joberger95/projet_BTS/Projet_BTS_2018/Programme/Problemes_Elec.JPG

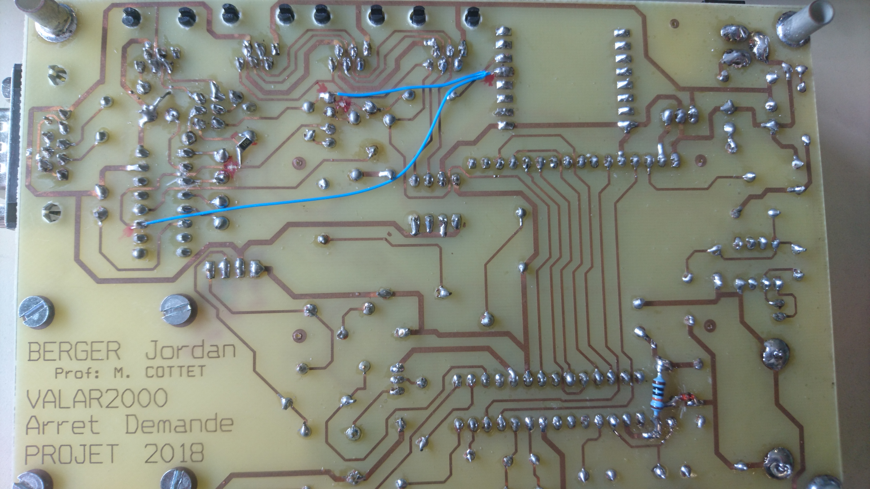
Projet_BTS_2018/Programme/Problemes_Elec.JPG
