joberger95/projet_BTS/Projet_BTS_2018/Dossier Module 4/Valideur V2000_Arrêt Demandé/Documentation/_Schéma Structurel/DSC_0121.JPG

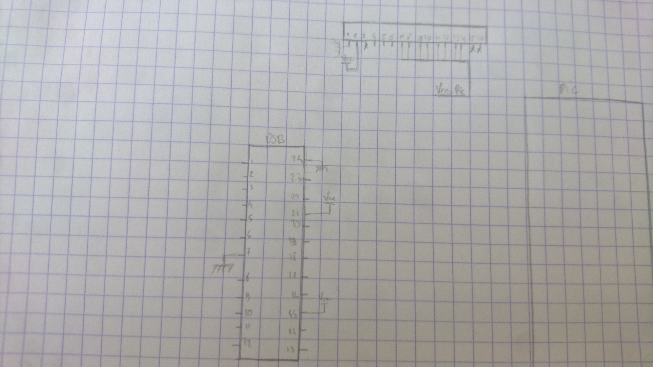
Projet_BTS_2018/Dossier Module 4/Valideur V2000_Arrêt Demandé/Documentation/_Schéma Structurel/DSC_0121.JPG
