joberger95/projet_BTS/Projet_BTS_2018/Programme/GSM_CPIN.txt

ANALOG
Ch 1 Scale 2 V/, Pos -250 mV, Coup DC, BW Off, Inv Off, Imp 1M Ohm
     Probe 10 : 1, Skew 0 s
Ch 2 Scale 2 V/, Pos 4.025 V, Coup DC, BW Off, Inv Off, Imp 1M Ohm
     Probe 10 : 1, Skew 0 s

TRIGGER
Sweep Mode Auto, Coup DC, Noise Rej Off, HF Rej Off, Holdoff 40.0 ns
Mode EDGE, Source Ch 2, Slope NEG, Level 1.25 V

HORIZONTAL
Mode WIND, Ref CENT, Main Scale 2 s/, Main Delay 9.64 s

ACQUISITION
Mode NORM, Realtime On, Vectors On, Persistence Off
