joberger95/projet_BTS/Projet_BTS_2018/Programme/Fiche_Recette.docx

FICHE RECETTE

RS232 chronogramme

I2C chronogrammes

Température

Heure

GSM chronogramme

Tension de Pile……………………………………………………………………………………………………………………OK

Alimentation générale………………………………………………………………………………………………………..OK

Bouton-poussoir…………………………………………………………………………………………………………………OK

LED………………………………………………………………………………………………………………………………….... OK
