joberger95/projet_BTS/Projet/Dossier Commun/Rapport_Projet.docx

BERGER Jordan BOUZJALLIKHT Ilyas GERMANT Rémy JOUY Florent

Arrêt Demandé

VALIDEUR V2000

Professeur : M. COTTET Jean-Jacques

# 2 PRESENTATION DU PROJET

L’association Arrêt Demandé s’occupe de la restauration, la rénovation et la remise en route de véhicules ayant roulés sur l’agglomération orléanaise. Par la préservation de ces véhicules passe la remise en œuvre des valideurs de tickets de ceux-ci. La difficulté étant la présence des pièces sur le marché ainsi que le manque de compétences dans ce domaine par les différents membres de l’association, leur ont permis d’être convaincu de faire appel à notre équipe.

Notre rôle sera de « mettre à jour » ces valideurs par l’apport de nouvelles solutions technologiques ainsi que par des solutions de maintenances efficaces et simplistes.

# 3 CAHIER DES CHARGES

Le projet propose la mise en œuvre des valideurs V2000 en réalisant de nouvelles cartes PIC et des logiciels programmés en C, qui assureront le déplacement, ainsi que les différentes parties lectures et impressions du ticket. Il se doit aussi être inséré des modules électroniques de communication pour permettre la supervision et la maintenance aisée du valideur. Il devra donc être présent un port USB et RS232 pour la récupération directe des données ainsi qu’une option GSM qui assurera l’envoi de SMS de dysfonctionnement(s) mais aussi capable de répondre à une demande d’informations.

Au vu de la complexité du système présent, les nouvelles cartes devront être reliées à la carte mère existante afin d’en conserver certaines parties, comme l’alimentation à découpage ou le bloc moteur.

La réussite de ce projet est essentielle car seuls des bus ont été remis en état pour des démonstrations, ne manquant plus que les valideurs. Le développement pourrait être poursuivi par l’utilisation de technologies CMS ou l’étude des valideurs V3000. L’idée de technologies innovantes comme l’utilisation de smartphones pour leurs modules NFC, RFID, etc… permettraient de motiver les jeunes de l’association et d’attirer un public plus large.

# 4 Schémas fonctionels

## 4.1 Schéma général

## 4.2 Schéma FP1_Motorisation et Puissance

## 4.3 Schéma FP2_Impression du Ticket

## 4.4 Schéma FP3_Lecture/Ecriture Magnétique

## 4.5 Schéma FP4_Centralisation des Données

# 5 COÛTS

Après plusieurs comparaisons et recherches sur les différents composants des cartes, le tableau suivant est ressorti :

*Tableau des coûts

Lycée Maurice GENVOIX 8 Année 2017-2018
