joberger95/projet_BTS/Projet/Dossier Module 4/Valideur V2000_Arrêt Demandé/Documentation/_Schéma Structurel/I2C/Nouveau Document Microsoft Word.docx

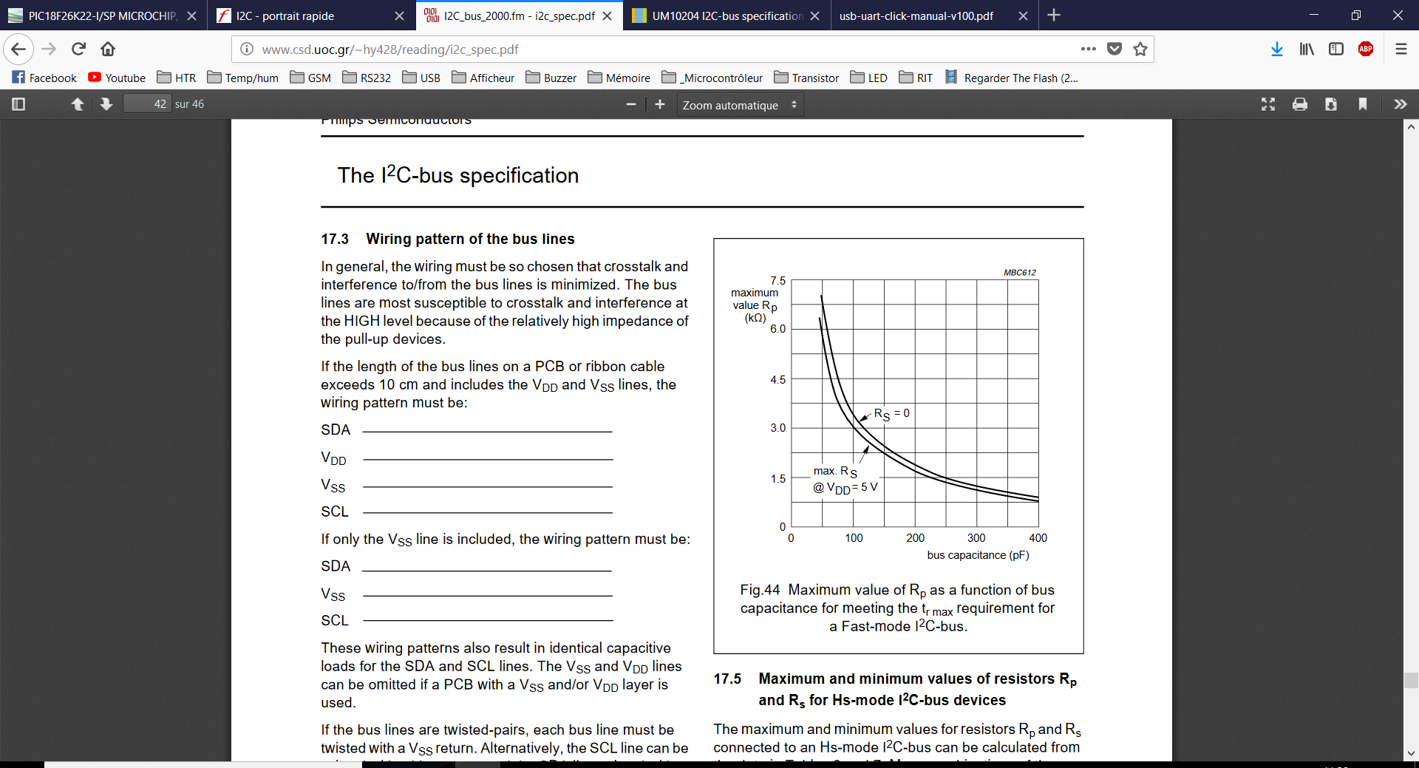
[picture p14: figure]
