joberger95/projet_BTS/Projet/Dossier Module 4/Valideur V2000_Arrêt Demandé/Documentation/_GANTT_Project/GANTT_BERGER.png

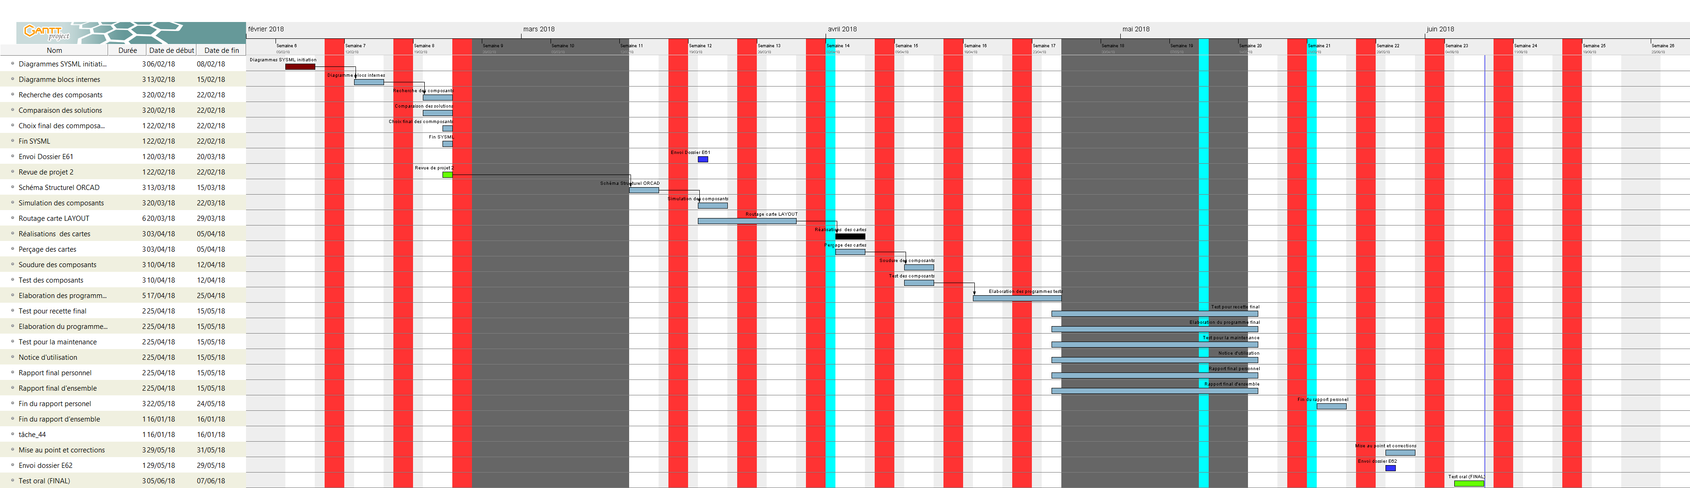
Projet/Dossier Module 4/Valideur V2000_Arrêt Demandé/Documentation/_GANTT_Project/GANTT_BERGER.png
