joberger95/projet_BTS/Projet/Dossier Module 4/Valideur V2000_Arrêt Demandé/Documentation/_Schéma Structurel/DSC_0123.JPG

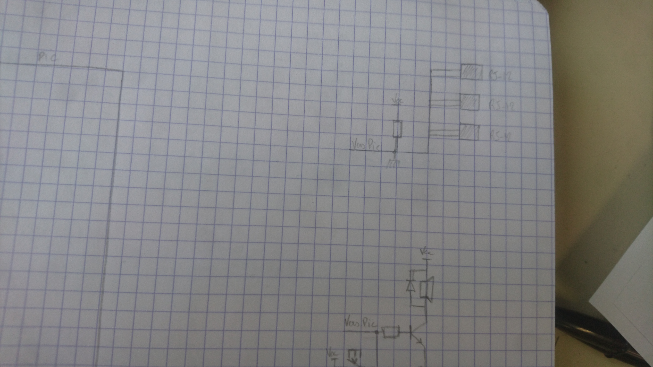
Projet/Dossier Module 4/Valideur V2000_Arrêt Demandé/Documentation/_Schéma Structurel/DSC_0123.JPG
