joberger95/projet_BTS/Projet_BTS_2018/Programme/Frequence_Horloge.png

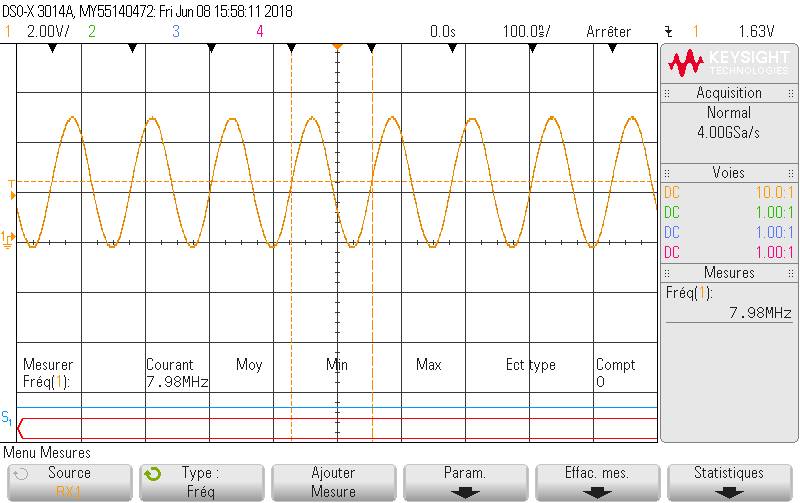
Projet_BTS_2018/Programme/Frequence_Horloge.png
