joberger95/projet_BTS/Projet_BTS_2018/Programme/GSM_Num.png

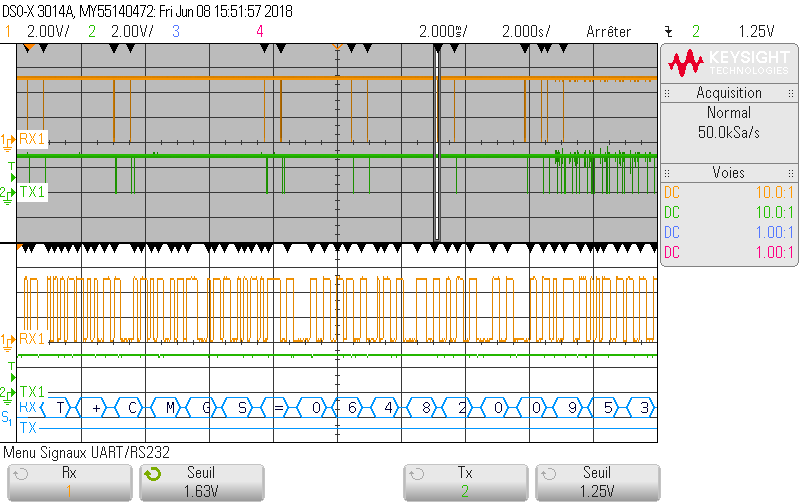
Projet_BTS_2018/Programme/GSM_Num.png
