joberger95/projet_BTS/Projet_BTS_2018/Programme/Programme_2.PNG

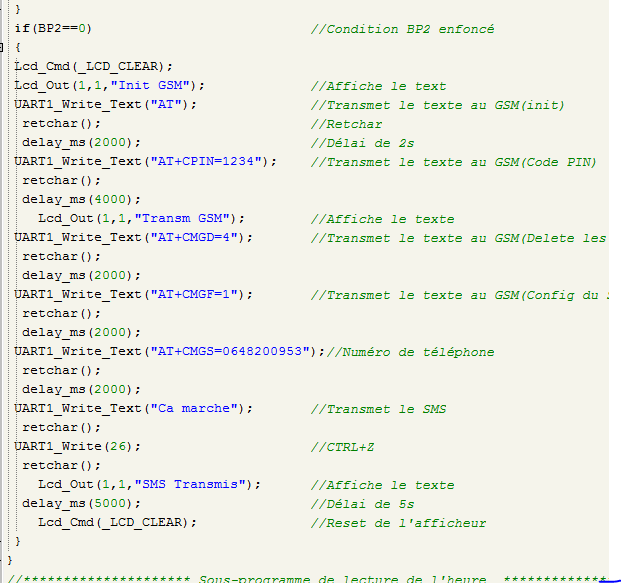
Projet_BTS_2018/Programme/Programme_2.PNG
