joberger95/projet_BTS/Projet_BTS_2018/Programme/RS232_A+CLRF.png

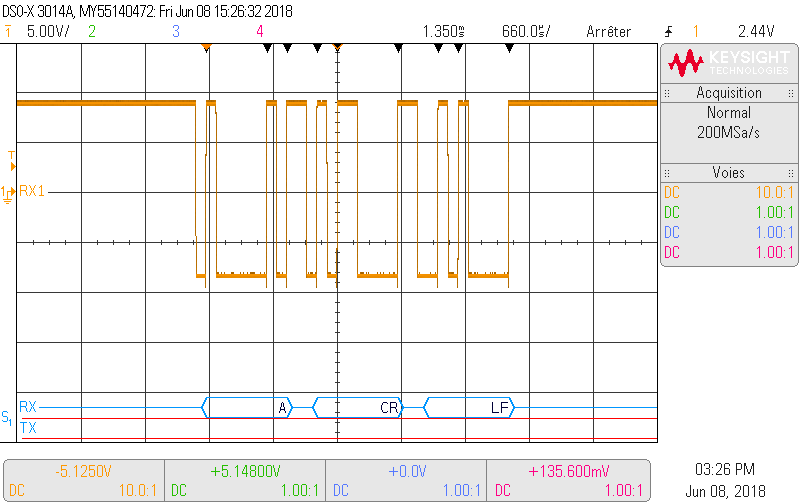
Projet_BTS_2018/Programme/RS232_A+CLRF.png
