joberger95/projet_BTS/Projet/Dossier Module 4/Valideur V2000_Arrêt Demandé/Documentation/Nomenclature.xlsx

NOMENCLATURE | COMPOSANTS | VALEURS | EMPLACEMENT | PRIX | CODE ARTICLE
Résistances | R1 | 330 Ω | RIT | 0.04 € | 2329514
 | R2 | 300 Ω | RS232 | 0.05 € | 2329916
 | R3 | 300 Ω |  | 0.05 €
 | R4 | 12k Ω | Buzzer | 0.02 € | 2453691
 | R5 | 300 Ω | SDA | 0.05 € | 2329916
 | R6 | 300 Ω | SCL | 0.05 €
 | R7 | 47k Ω | PIC | 0.03 € | 2453712
 | R8 | 470 Ω |  | 0.03 € | 1357858
 | R9 | 24k Ω | Boutons Poussoir | 0.01 € | 2329648
 | R10 | 24k Ω |  | 0.01 € | 2329648
 | R11 | 330 Ω | LED PIC | 0.04 € | 2329514
Condensateurs Polarisés | C1 | 220µF/25V | RIT
 | C2 | 100µF/6,3V
 | C3 | 1µF | RS232
 | C4 | 1µF
 | C5 | 1µF
 | C6 | 1µF
Condensateurs Céramiques | C1 | 15pF | Quartz PIC
 | C2 | 15pF
 | C3 | 1nF | Quartz HTR
 | C4 | 1nF
LED | D1 | 3mm Rouge | RIT | 0.04 €
 | D2 | 3mm Vertes | RS232 | 0.08 €
 | D3
 | D4 | 5mm Jaune | PIC | 0.14 €
Boutons Poussoir | BP1 | x | PIC | 0.81 € | 2435326
 | BP2 | x |  | 0.81 € | 2435326
Points-tests | Pt 1 | x | Pile HTR
 | Pt 2 | x | TxD
 | Pt 3 | x | RxD
 | Pt 4 | x | SCL
 | Pt 5 | x | SDA
 | Pt 6 | x | TX1
 | Pt 7 | x | RX1
Potentiomètre | P1 | 10k | Afficheur
Connecteurs RJ12 | J1 | x | Programmateur PIC
 | J2 | x | I2c
 | J3 | x | I2c
 | J4 | x | I2c
Autres | Sup1 | 4 Pins | Capteur Temp/Hum
 | Sup2 | 16 Pins | Afficheur
 | Sup3 | 4 Pins | GSM
 | Sup4 | 16 Pins | USB
 | Pile | 3V | HTR
 | Commutateur | Type double | PIC
Connecteur DP-9 | J5 | 9 Broches | RS232
Transistor | Q1 | BC547B | Buzzer | 0.24 €
Quartz | X1 | 32 768Hz | HTR | 0.12 € | 2849539
 | X2 | 8Mhz | PIC | 0.39 € | 2371864
Diodes | D1 | 1N4001 | RIT
 | D2 | 1N4148 | Pile HTR
 | D3 | 1N4148 | HTR
 | D4 | 1N4148 | RS232
 | D5 | 1N4148 | RS232
Composants | PIC | PIC18F26k22
 | Afficheur LCD | MC21605J6W |  | 4.74 €
 | HTR | MCP7940M |  | 0.65 €
 | Buzzer | KXG1205 |  | 0.49 €
 | GSM | GSM/GPRS TELo113 |  | 20.90 €
 | RS232 | MAX232 |  | 2.03 €
 | USB | USB UART Click |  | 11 €
 | Temp/Hum | HIH8120 |  | 7.68 €
 | Mémoire | AT24C512C |  | 0.76 €
Carte Cuivrée |  | 10*15cm
 |  |  | Total | 51.2632
