joberger95/projet_BTS/Projet/Dossier Module 4/Valideur V2000_Arrêt Demandé/Documentation/Commande_Composants.xlsx

Tableau Final | REFERENCE | FOURNISSEUR | CODE COMMANDE | PRIX
GSM | Module UART GSM/GPRS TEL0113 | GoTronic | 35486 | 20.90 €
Afficheur | MC21605J6W | Farnell | 2675620 | 10.20 €
HTR | MCP7940M | Farnell | 2098894 | 0.65 €
Temp/Hum | HIH8120 | Farnell | 2356756 | 7.96 €
Mémoire | Microchip 24LC512 | Farnell | 9758020 | 1.37 €
RS232 | TI MAX232 NG4 | Farnell | 9589805 | 0.93 €
USB | USB UART click | Farnell | 2507514 | 12.41 €
Buzzer | KXG1205C | Farnell | 2215080 | 1.29 €
LED Rouge | 703-0095 | Farnell | 2112106 | 0.04 €
LED Verte | L-53SGC | Farnell | 1142572 | 0.08 €
LED Jaune | MCL053YT | Farnell | 1581147 | 0.14 €
Transistor | BC547B | Farnell | 1017673 | 0.23 €
RIT | L78L05ACZTR | Farnell | 2474022 | 0.06 €
PIC | PIC18F26k22 | Farnell | 1814975 | 2.80 €
Quartz | 9B-8.000MEEJ-B | Farnell | 1842269 | 0.60 €
Boutons-Poussoir
Diodes
Commutateur Double
Connecteurs RJ-12
Connecteur DB-9
Résistances
Potentiomètre
Condensateurs
Pile
Point-Tests
 |  |  | Total | 59.66 €
