joberger95/projet_BTS/Projet_BTS_2018/Dossier Module 4/_Programme/V2000_JB_Test1.mcppi_callertable.txt

main
	__CC2DW
	config
		Lcd_Init
			Delay_5500us
			Delay_1us
		Lcd_Cmd
			Delay_1us
			Delay_5500us
			Delay_50us
	affichage
		Lcd_Out
			Lcd_Cmd
				Delay_1us
				Delay_5500us
				Delay_50us
			Lcd_Chr_CP
				Lcd_Cmd
					Delay_1us
					Delay_5500us
					Delay_50us
