joberger95/projet_BTS/Projet/Schéma_Structurel.pdf

AFFICHAGE LCD PT1 Vcc Vcc | | Pile 3V CR2032

### MICROCONTROLEUR

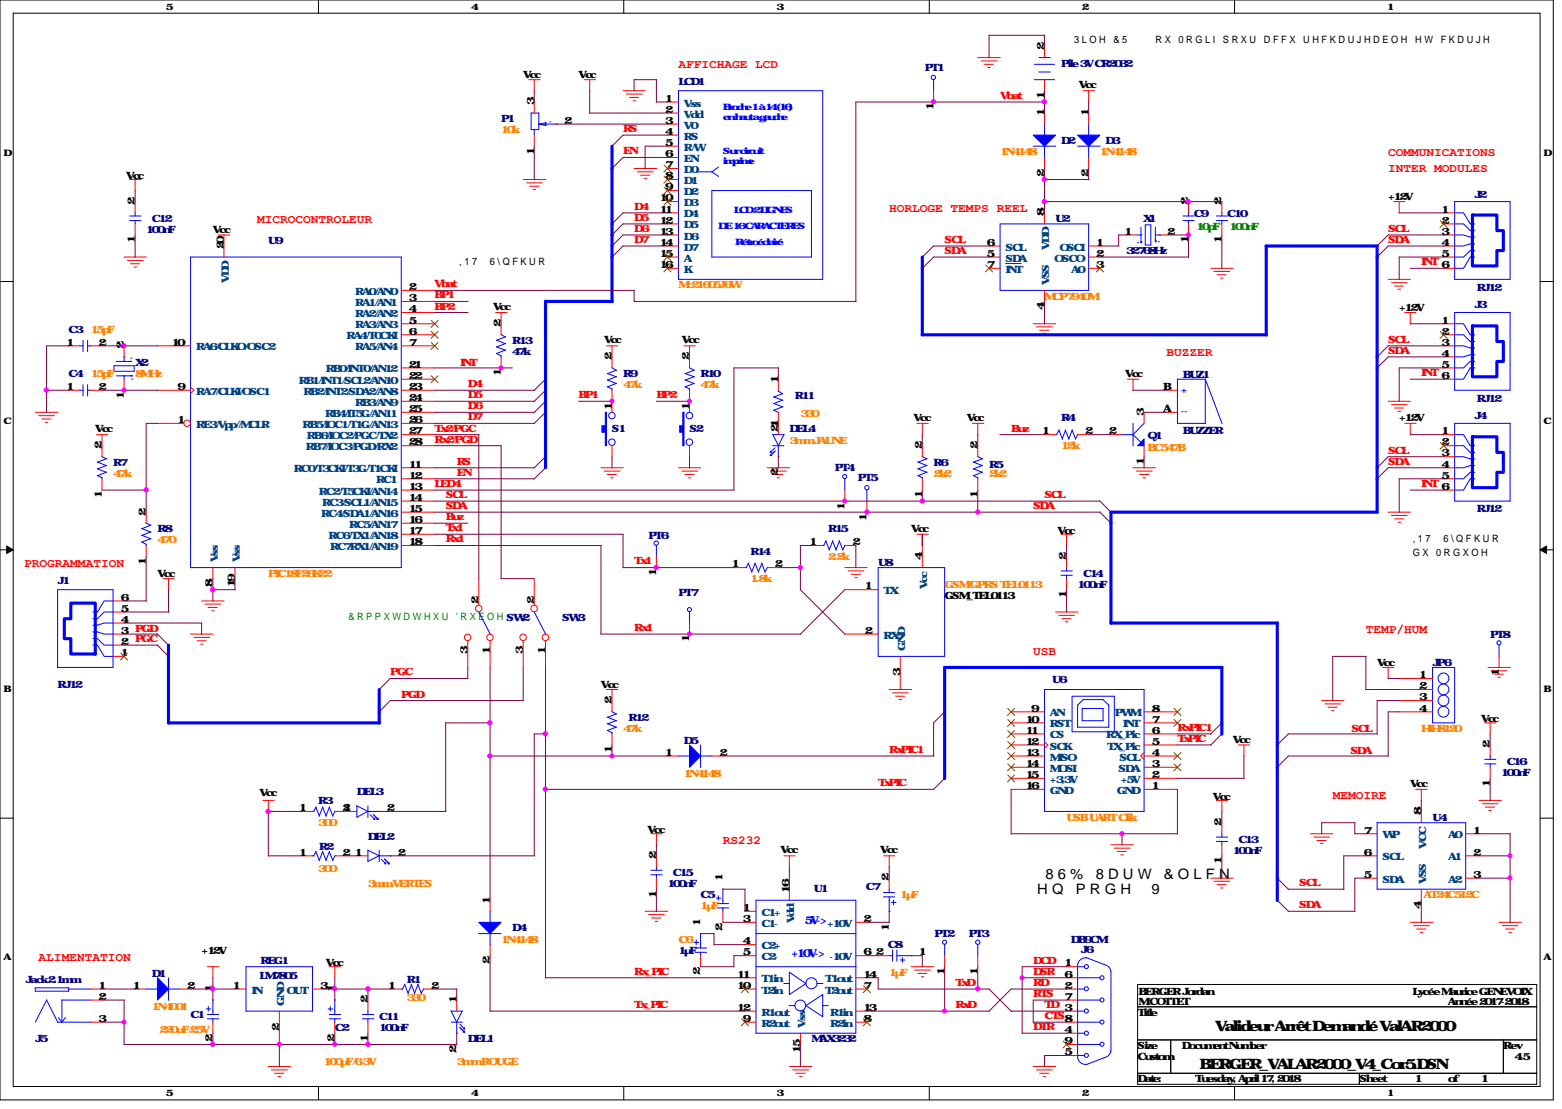
[picture p40: page 1]

Broche 1 à 14 (16) en haut a gauche

LCD 2 LIGNES DE 16 CARACTERES

14
15 | SDA
16

8 A0A1 VSS A2 SCL SDA WP VCC

Tuesday, April 17, 2018 Lycée Maurice GENEVOIX 1 1 M.COTTET BERGER Jordan

CTS 8
