joberger95/projet_BTS/Projet/LAYOUT.pdf

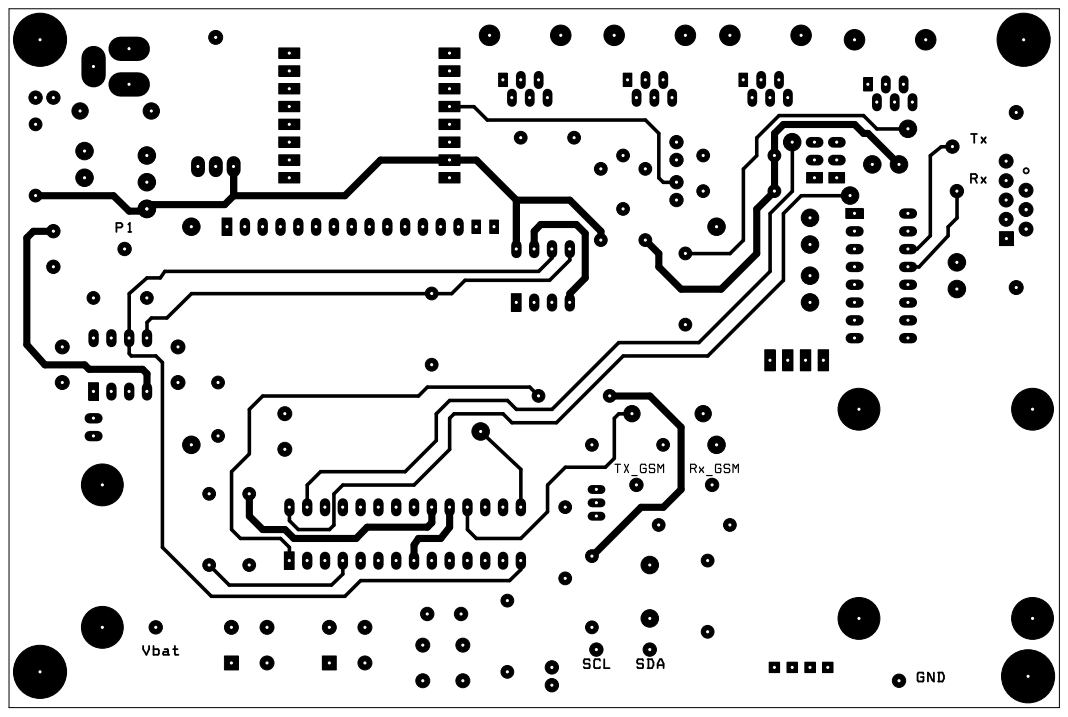
[picture p41: page 1]
