joberger95/projet_BTS/Projet/LAYOUT1.pdf

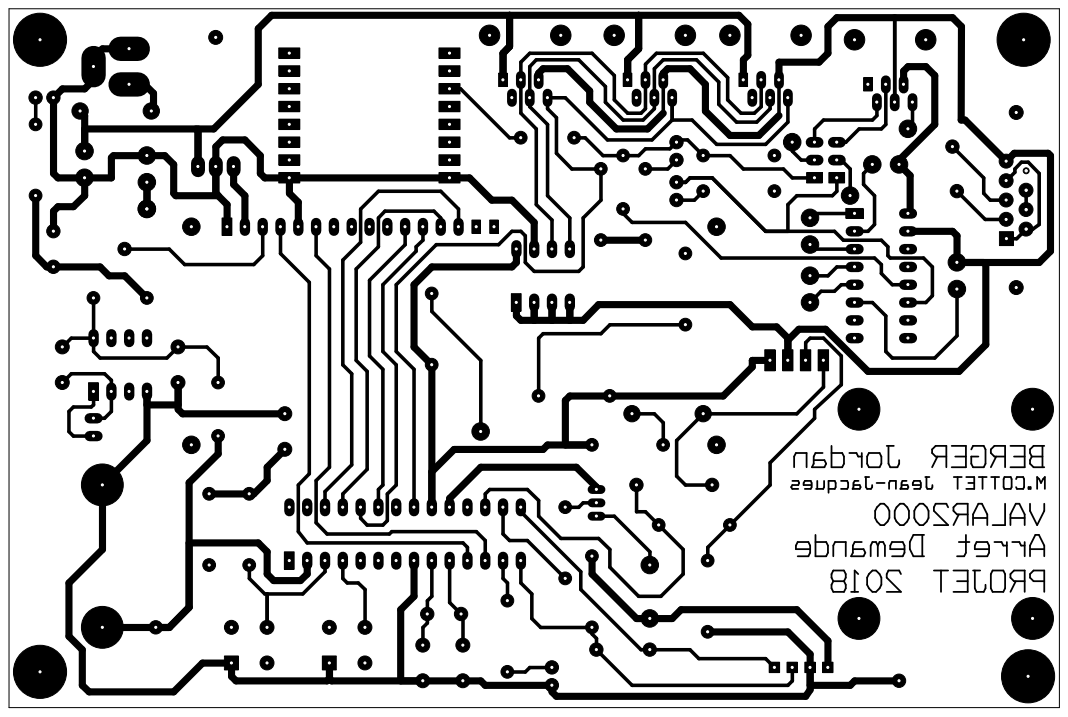
[picture p42: page 1]
