joberger95/projet_BTS/Projet/LAYOUT2.pdf

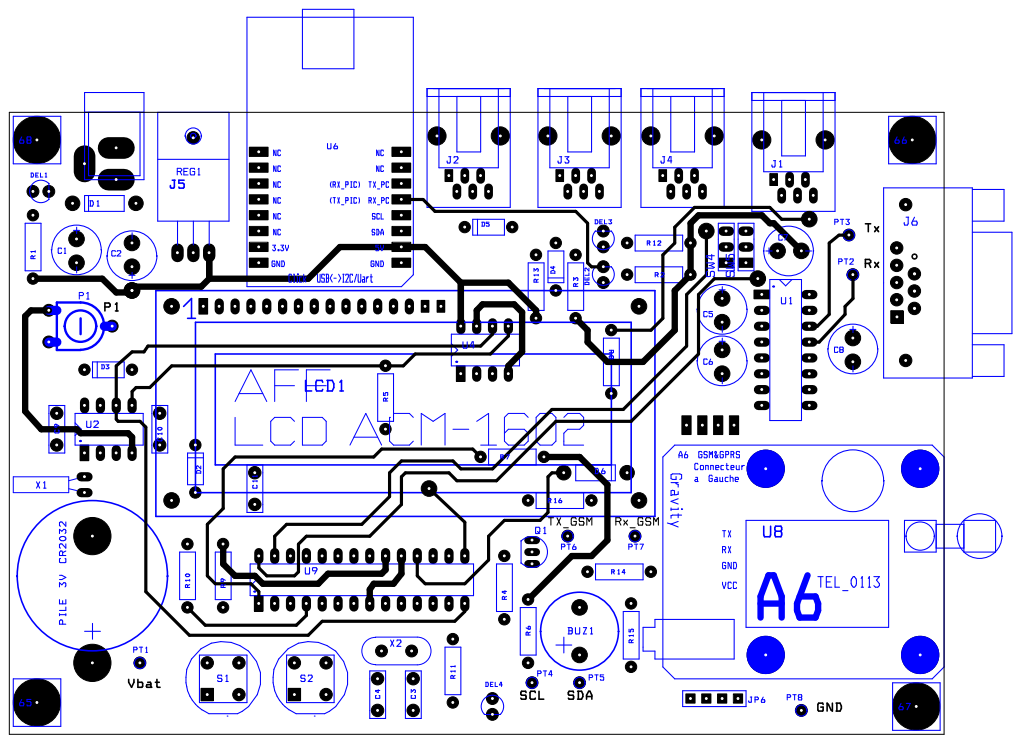
[picture p43: page 1]
