joberger95/projet_BTS/Projet/LAYOUT3.pdf

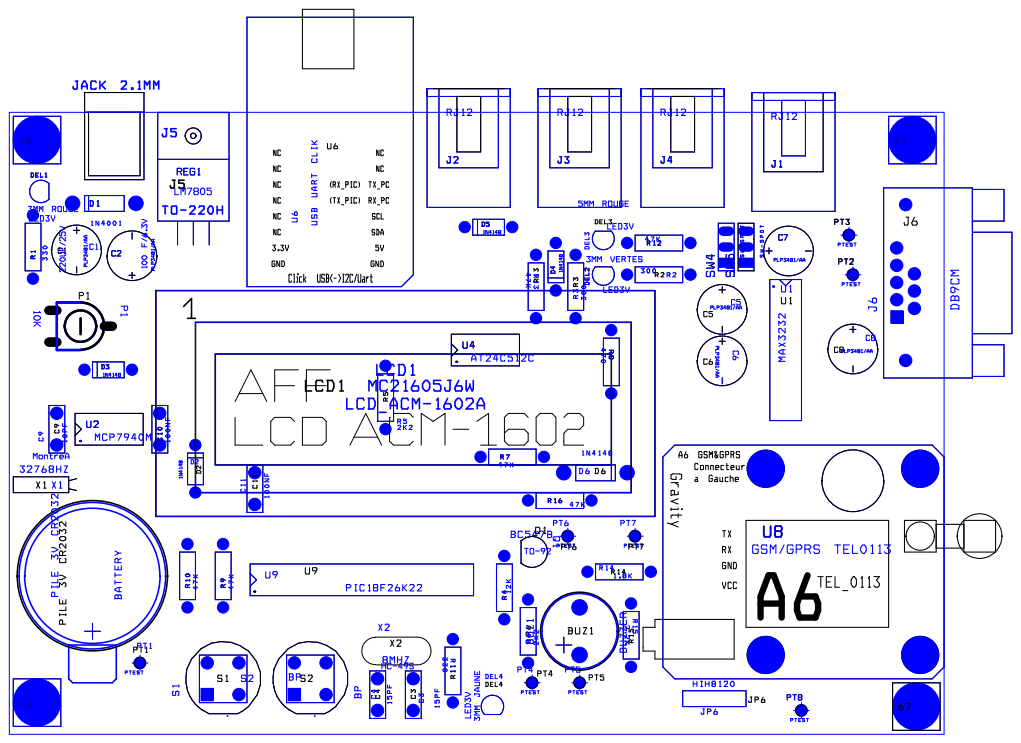
[picture p44: page 1]
