joberger95/projet_BTS/Projet/Dossier Module 4/Valideur V2000_Arrêt Demandé/Documentation/_Schéma Structurel/Carte pic universelle_V4_o5.pdf

## POTAJ

# Carte PIC Universelle

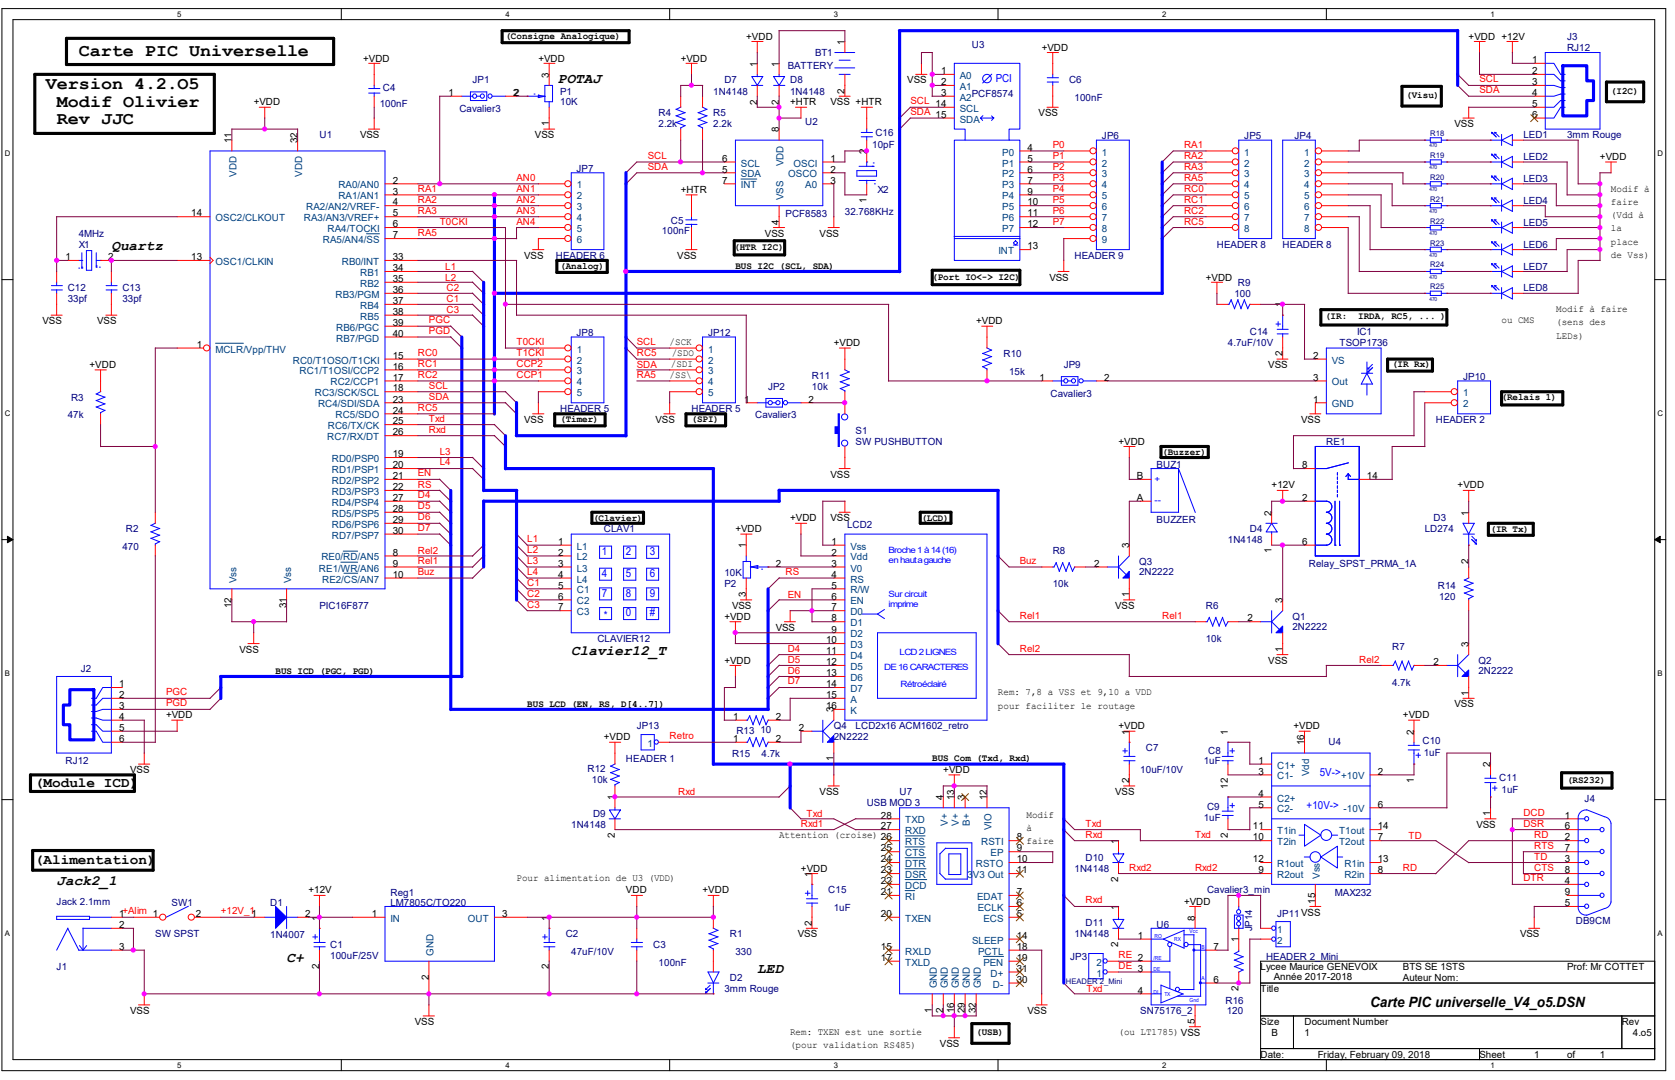
[picture p45: page 1]

25 RC7/RX/DT RD4/PSP4 RD5/PSP5 RD6/PSP6 RD7/PSP7 Vss VDD

26 Rxd

120 Broche 1 à 14 (16) en haut a gauche

LCD 2 LIGNES DE 16 CARACTERES

BUS ICD (PGC, PGD)

BUS LCD (EN, RS, D[4..7])

Rem: 7,8 a VSS et 9,10 a VDD
pour faciliter le routage

BUS Com (Txd, Rxd)
+VDD

EDAT RSTI EP RSTO

Pour alimentation de U3 (VDD)

Rem: TXEN est une sortie
(pour validation RS485)

Friday, February 09, 2018 | 1 1
