joberger95/projet_BTS/(list of files, drawings)

Other design files:
Projet/Anciens fichiers/BERGER_VALAR2000 COR2.DSN
Projet/Anciens fichiers/BERGER_VALAR2000 Cor2.opj
Projet/Anciens fichiers/BERGER_VALAR2000 COR3.DSN
Projet/Anciens fichiers/BERGER_VALAR2000.DSN
Projet/Anciens fichiers/BERGER_VALAR2000.OPJ
Projet/Anciens fichiers/BERGER_VALAR2000_COR1.DSN
Projet/Anciens fichiers/BERGER_VALAR2000_Cor1.opj
Projet/Anciens fichiers/BERGER_VALAR2000_V2.DSN
Projet/Anciens fichiers/BERGER_VALAR2000_V2.opj
Projet/Anciens fichiers/BERGER_VALAR2000_V3.DSN
Projet/Anciens fichiers/BERGER_VALAR2000_V3.opj
Projet/Anciens fichiers/BERGER_VALAR2000_V3_COR4 - Copie.DSN
Projet/Anciens fichiers/BERGER_VALAR2000_V3_Cor4 - Copie.opj
Projet/Anciens fichiers/BERGER_VALAR2000_V3_COR4.DSN
Projet/Anciens fichiers/BERGER_VALAR2000_V3_Cor4.opj
Projet/Anciens fichiers/BERGER_VALAR2000_V3_COR4_3.DSN
Projet/Anciens fichiers/BERGER_VALAR2000_V3_Cor4_3.opj
Projet/Anciens fichiers/DESIGN3.DSN
Projet/Anciens fichiers/Design3.opj
Projet/Anciens fichiers/Design4 Cor4.opj
Projet/BERGER_VALAR2000_V4.DSN
Projet/berger_valar2000_v4.opj
Projet/BERGER_VALAR2000_V4_COR5.DSN
Projet/berger_valar2000_v4_Cor5.opj
Projet/Dossier Module 4/_ORCAD/BERGER_VALAR2000_V4.DSN
Projet/Dossier Module 4/_ORCAD/berger_valar2000_v4.opj
Projet/Dossier Module 4/Valideur V2000_Arrêt Demandé/Documentation/_Librarie ORCAD/BTS_2018.OLB
Projet/Dossier Module 4/Valideur V2000_Arrêt Demandé/Documentation/_Schéma Structurel/ORCAD/BERGER_VALAR2000.DSN
Projet/Dossier Module 4/Valideur V2000_Arrêt Demandé/Documentation/_Schéma Structurel/ORCAD/BERGER_VALAR2000_V2.DSN
Projet/Dossier Module 4/Valideur V2000_Arrêt Demandé/Documentation/_Schéma Structurel/ORCAD/BERGER_VALAR2000_V2.opj
Projet/Dossier Module 4/Valideur V2000_Arrêt Demandé/Documentation/_Schéma Structurel/ORCAD/DESIGN3.DSN
Projet/Dossier Module 4/Valideur V2000_Arrêt Demandé/Documentation/_Schéma Structurel/ORCAD/Design3.opj
Projet_BTS_2018/Dossier Module 4/_ORCAD/BERGER_VALAR2000_V4.DSN
Projet_BTS_2018/Dossier Module 4/_ORCAD/berger_valar2000_v4.opj
Projet_BTS_2018/Dossier Module 4/_ORCAD/berger_valar2000_v4_Cor5.opj
Projet_BTS_2018/Dossier Module 4/Valideur V2000_Arrêt Demandé/Documentation/_Librarie ORCAD/BTS_2018.OLB
Projet_BTS_2018/Dossier Module 4/Valideur V2000_Arrêt Demandé/Documentation/_Schéma Structurel/ORCAD/BERGER_VALAR2000.DSN
Projet_BTS_2018/Dossier Module 4/Valideur V2000_Arrêt Demandé/Documentation/_Schéma Structurel/ORCAD/BERGER_VALAR2000_V2.DSN
Projet_BTS_2018/Dossier Module 4/Valideur V2000_Arrêt Demandé/Documentation/_Schéma Structurel/ORCAD/BERGER_VALAR2000_V2.opj
Projet_BTS_2018/Dossier Module 4/Valideur V2000_Arrêt Demandé/Documentation/_Schéma Structurel/ORCAD/DESIGN3.DSN
Projet_BTS_2018/Dossier Module 4/Valideur V2000_Arrêt Demandé/Documentation/_Schéma Structurel/ORCAD/Design3.opj
