joberger95/projet_BTS/Projet_BTS_2018/Dossier Module 4/_Programme/I2C.c

/*BERGER Jordan               VALAR2000
  Chef de Projet: M.COTTET Jean-Jacques
  Entreprise: Association Arret Demande
  Projet BTS 2017/2018 Lycee M.GENEVOIX
But: Programme de test de la communica-
     tion I2C

LATA RA5      RA4      RA3    RA2     RA1     RA0
     NC       NC       NC     BP2     BP1     Vbat
     E        E        E      E       E       E
     0b11111111        0xFF

LATB RB7      RB6      RB5    RB4     RB3     RB2     RB1     RB0
     RX2/PGD  Tx2/PGC  D7     D6      D5      D4      NC      INT
     E        S        S      S       S       S       E       E
     0b10000011       0x13

LATC RC7      RC6      RC5    RC4     RC3     RC2     RC1     RC0
     Rx1      Tx1      Buz    SDA     SCL     LED4    EN      RS
     E        S        S      E       S       S       S       S
     0b10010000        0x90

LATE RE3
     /MCLR
     E
     0b11111111       0xFF
/*****Configuration de l'Afficheur****/
sbit LCD_RS at RC0_bit;
sbit LCD_EN at RC1_bit;
sbit LCD_D4 at RB2_bit;
sbit LCD_D5 at RB3_bit;
sbit LCD_D6 at RB4_bit;
sbit LCD_D7 at RB5_bit;

sbit LCD_RS_Direction at TRISC0_bit;
sbit LCD_EN_Direction at TRISC1_bit;
sbit LCD_D4_Direction at TRISB2_bit;
sbit LCD_D5_Direction at TRISB3_bit;
sbit LCD_D6_Direction at TRISB4_bit;
sbit LCD_D7_Direction at TRISB5_bit;
/*******Definiton des Programmes******/
void config(void);
void comHTR(void);
/*******Defintion des Variables*******/
#define BP1 PORTA.F1                 //Associe à PORTA.F1 le nom BP1
#define BP2 PORTA.F2                 //Associe à PORTA.F2 le nom BP2
#define LED PORTC.F2                 //Associe à PORTC.F2 le nom LED
/**************************PROGRAMME PRINCIPAL*********************************/
void main()
{
   config();                         //Appel le sous-programme

    comHTR();

}
void config()
{
   ANSELA=0x00;                      //Passe toutes les broches en digital
   ANSELB=0x00;
   ANSELC=0x00;
   TRISA=0xFF;                       //0b11111111
   TRISB=0x13;                       //0b10000011
   TRISC=0x90;                       //0b10010000
   TRISE=0xFF;                       //0x11111111

   Lcd_Init();                       //Initialisation LCD
   Lcd_Cmd(_LCD_CLEAR);              //Reset afficheur LCD
   Lcd_Cmd(_LCD_CURSOR_OFF);         //Désactive le curseur
   delay_ms(200);
   
   UART1_Init(9600);                 //Initialisation GSM
   UART2_Init(9600);                 //Initialisation RS232
   
   I2C1_Init(100000);
   
   Lcd_Out(1,1,"Essai HTR");
   delay_ms(4000);
}
void comHTR
{
 char reponse;
//Ecriture
  I2C1_Wr(0x00);
  I2C1_Wr(0x1F);
I2C1_Repeated_Start();
  I2C1_Wr(0x01);
  I2C1_Wr(0x0F);
I2C1_Repeated_Start();
  I2C1_Wr(0x02);
  I2C1_Wr(0x0F);
I2C1_Start();
  I2C1_Wr(0b1101110);
I2C1_Repeated_Start();
  I2C1_Wr(0x07);
  I2C1_Wr(0xF);
I2C1_Repeated_Start();
  I2C1_Wr(0x04);
  I2C1_Wr(0x05);
I2C1_Repeated_Start();
  I2C1_Wr(0x05);
  I2C1_Wr(0x0F);
I2C1_Repeated_Start();
  I2C1_Wr(0x06);
  I2C1_Wr(0x0F);
I2C1_Stop();


//Lecture
I2C1_Start();
  I2C1_Wr(0b11011110);
  I2C1_Wr(0x00);
I2C1_Repeated_Start();
  I2C1_Wr(0b1101111);
  reponse=I2C1_Rd(0);
I2C1_Stop();
  
  Lcd_Out(1,1,reponse);
}
